meyubcan/stm32-4s-bms-home-automation/docs/img/schematic-1-power.png

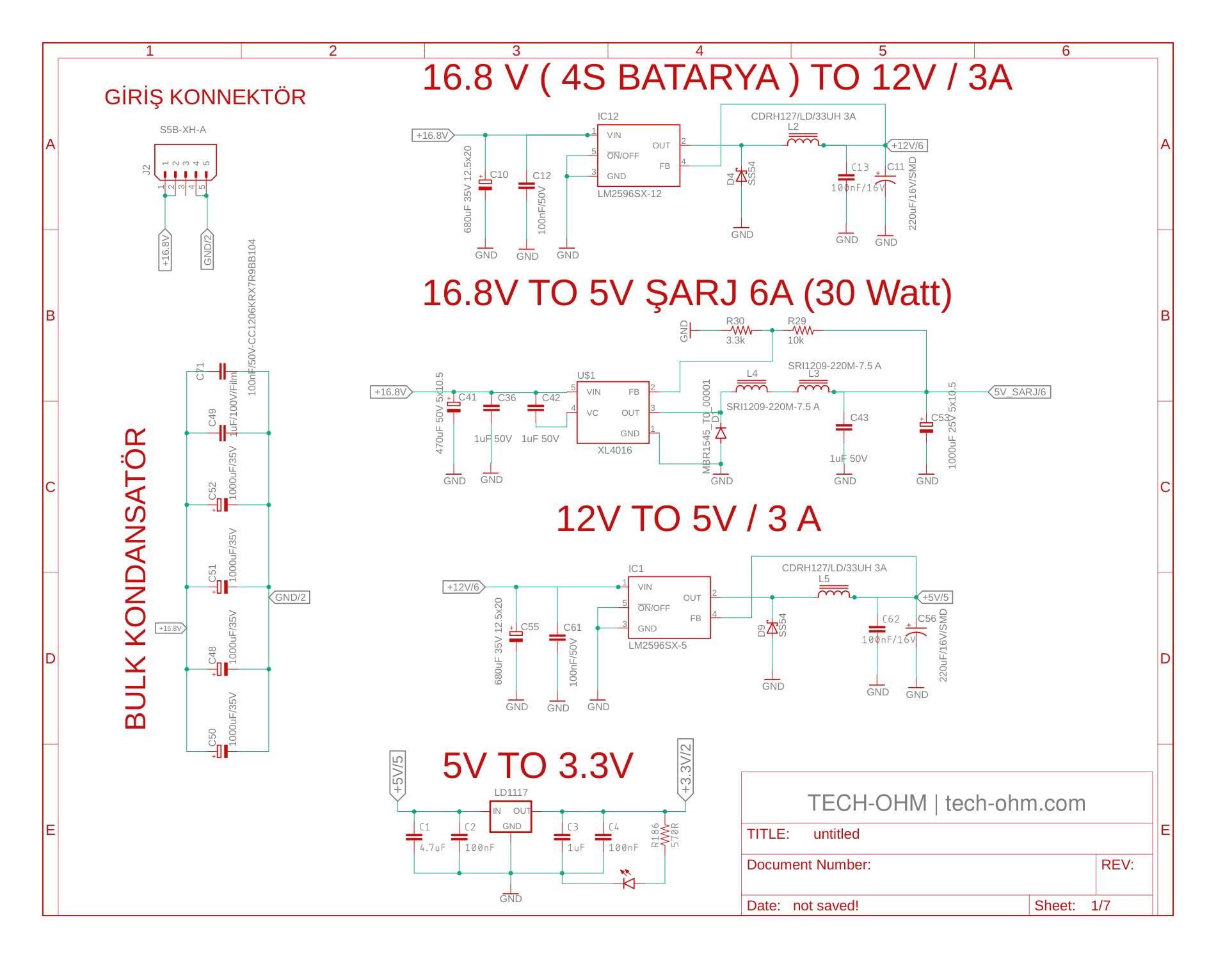
docs/img/schematic-1-power.png
