meyubcan/stm32-4s-bms-home-automation/docs/img/schematic-2-mcu.png

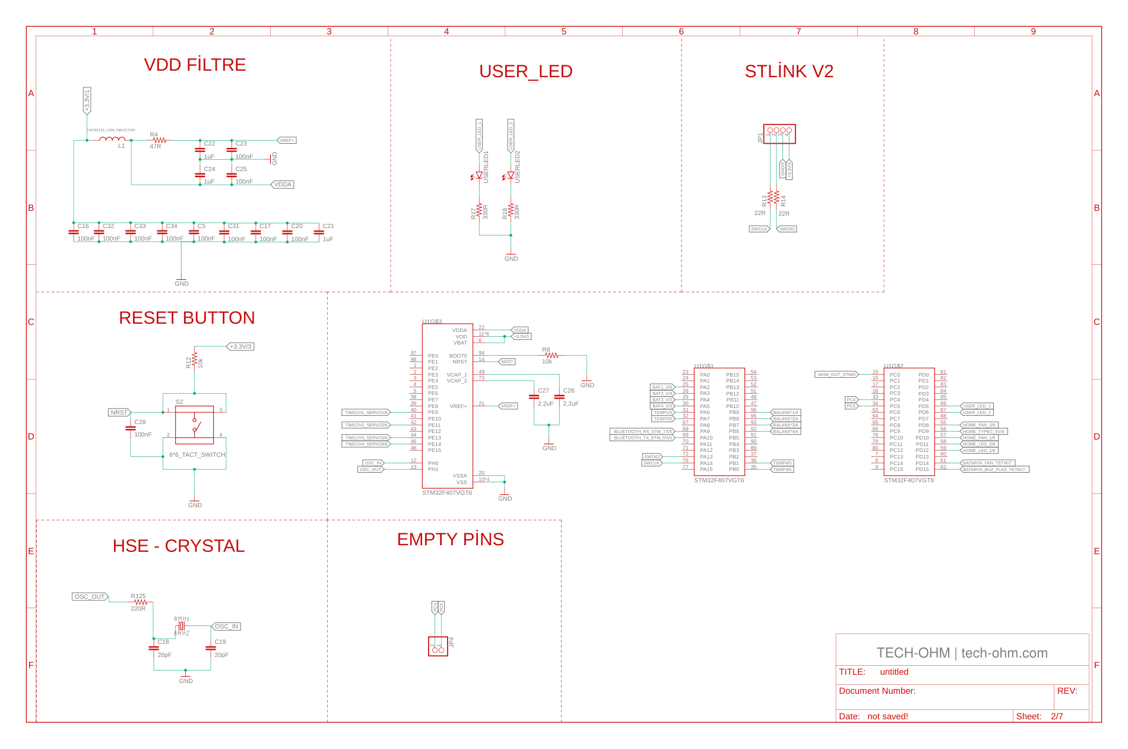
docs/img/schematic-2-mcu.png
