meyubcan/stm32-4s-bms-home-automation/docs/img/schematic-3-cell-voltage.png

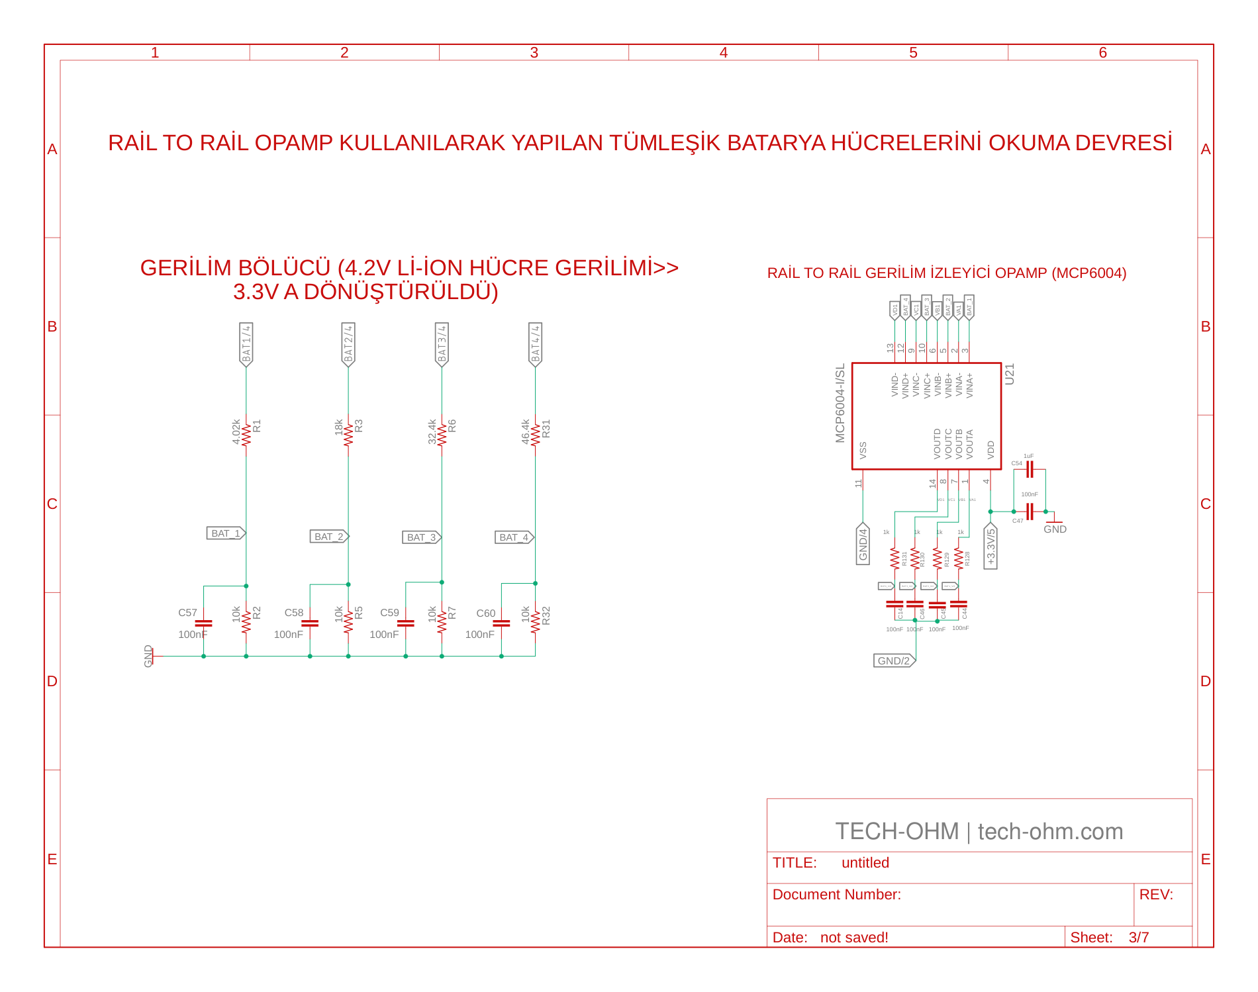
docs/img/schematic-3-cell-voltage.png
