meyubcan/stm32-4s-bms-home-automation/docs/img/schematic-4-balancing.png

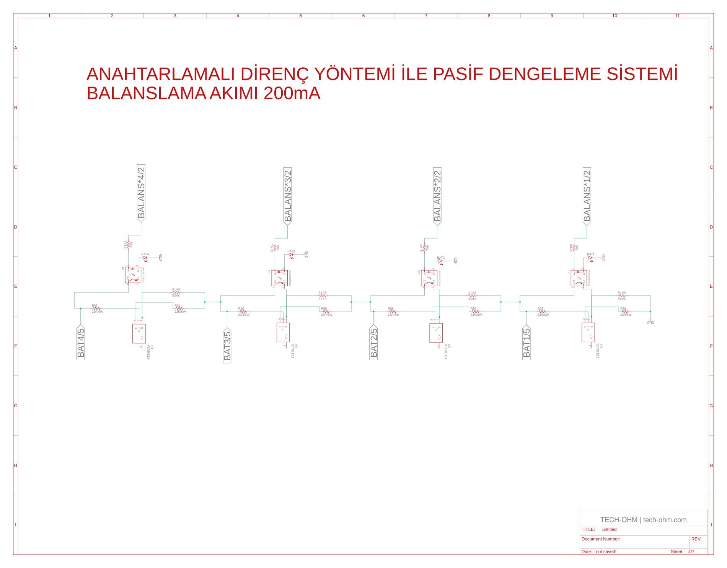
docs/img/schematic-4-balancing.png
