meyubcan/stm32-4s-bms-home-automation/docs/img/schematic-5-current-temp-bluetooth.png

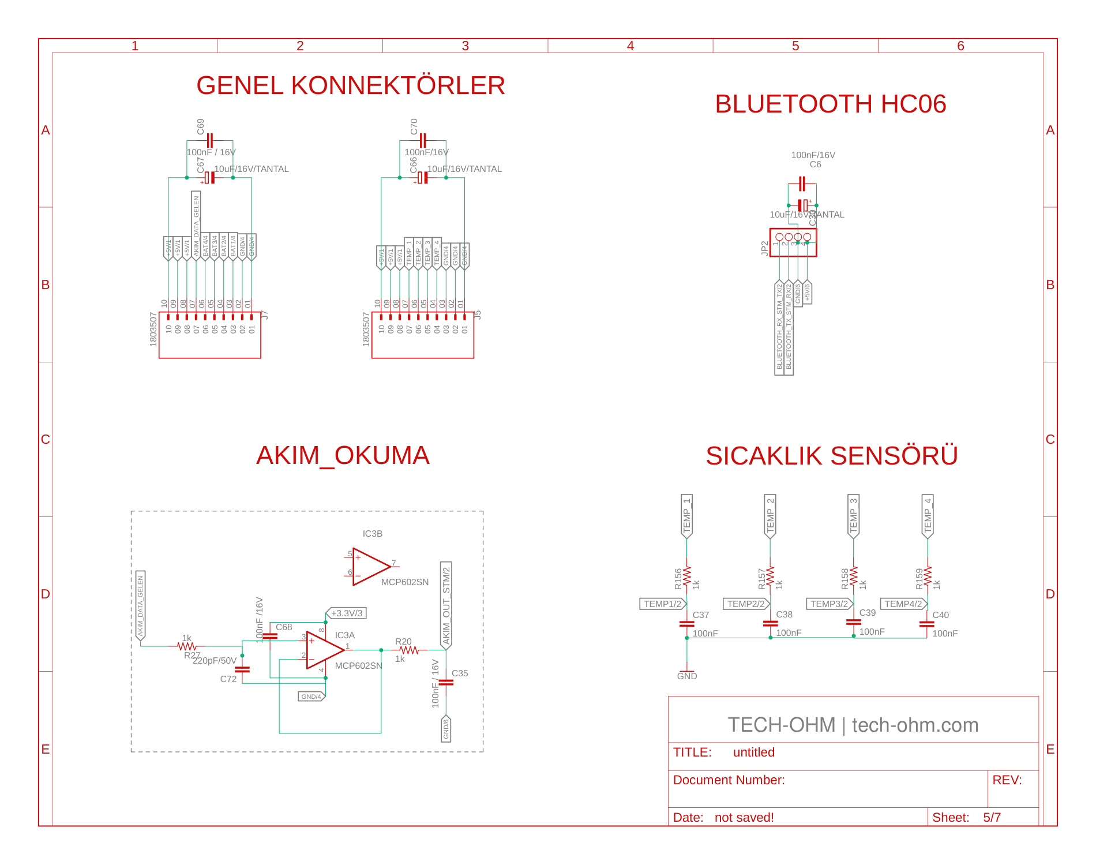
docs/img/schematic-5-current-temp-bluetooth.png
