meyubcan/stm32-4s-bms-home-automation/docs/img/schematic-6-home-control.png

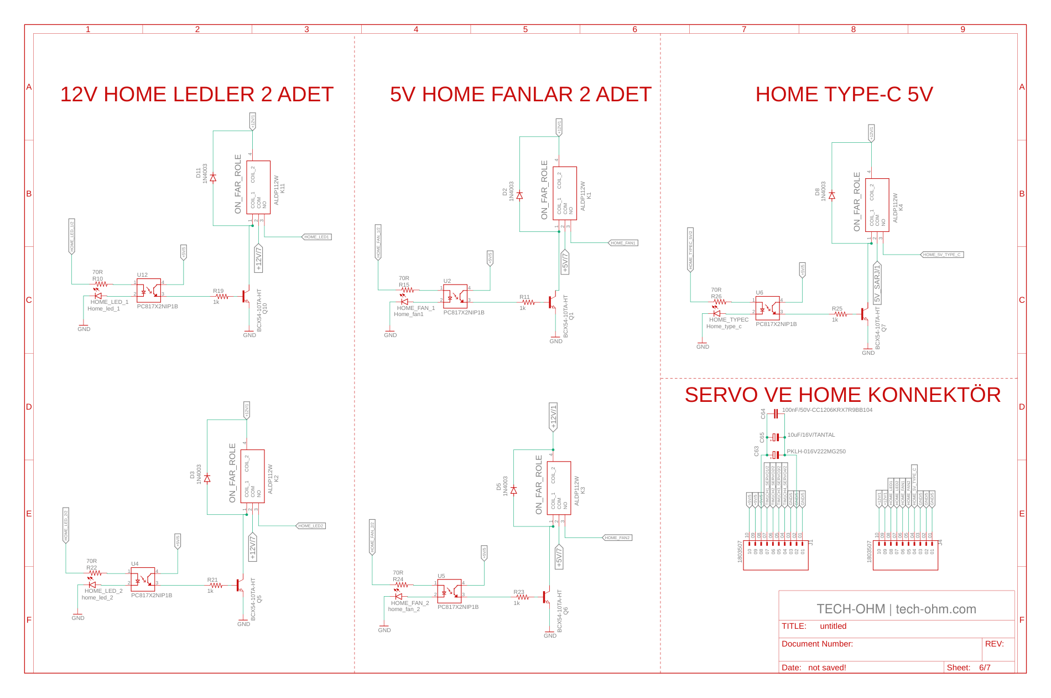
docs/img/schematic-6-home-control.png
