meyubcan/stm32-4s-bms-home-automation/docs/img/schematic-7-fan-buzzer.png

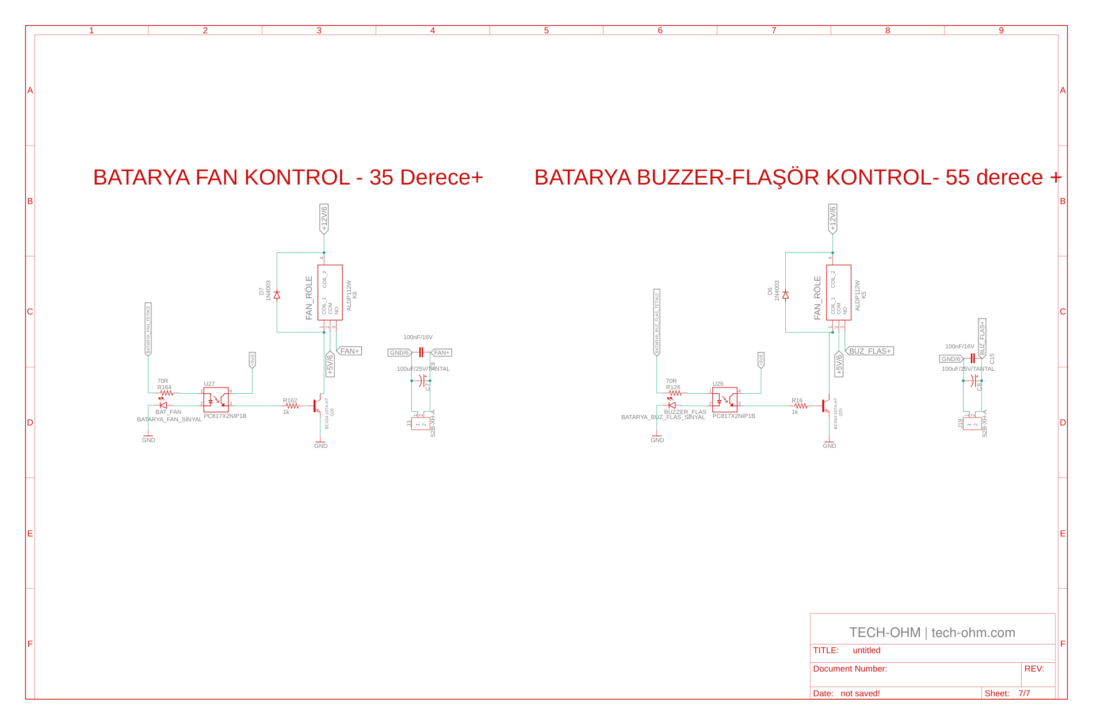
docs/img/schematic-7-fan-buzzer.png
