meyubcan/stm32-4s-bms-home-automation/docs/bom.csv

Qty | Value | Package | Designators
1 | STM32F407VGT6 | LQFP-100 | U1
1 | LM2596SX-12 | TO263-5 | IC12
1 | LM2596SX-5 | TO263-5 | IC1
1 | XL4016 | TO220-5 | U$1
1 | LD1117 3.3 V | SOT223 | LD1117
1 | MCP6004-I/SL | SOIC-14 | U21
1 | MCP602SN | SO08 | IC3
4 | PC817X2NIP0F | SMD-4 | U8, U9, U10, U11
7 | PC817X2NIP1B | SMD-4 | U2, U4, U5, U6, U12, U26, U27
7 | ALDP112W relay | ALDP112W | K1, K2, K3, K4, K5, K6, K11
7 | BCX54-10TA | SOT89 | Q1, Q5, Q6, Q7, Q10, Q25, Q26
4 | FZT851TA | SOT223 | Q2, Q3, Q4, Q9
1 | MBR1545 | TO220AC | D1
2 | SS54 | SMB | D4, D9
7 | 1N4003 | DO41 | D2, D3, D5, D6, D7, D8, D11
1 | 8 MHz crystal | HC49US | 8MHZ
2 | 33 uH 3 A (CDRH127) | CDRH127 | L2, L5
2 | 22 uH 7.5 A (SRI1209-220M) | SRI1209 | L3, L4
1 | 742792133 (VDDA filter) | 1206 | L1
8 | 23R 6 W | R2512 | R55, R56, R57, R58, R59, R60, R61, R62
4 | 560k | R0805 | R190, R193, R196, R199
4 | 70R | R0805 | R191, R194, R197, R200
7 | 70R | M0805 | R10, R15, R22, R24, R26, R126, R164
1 | 570R | R0805 | R186
12 | 1k | M0805 | R11, R16, R19, R20, R21, R23, R25, R156, R157, R158, R159, R162
5 | 1k | R0805 | R27, R128, R129, R130, R131
6 | 10k | R0805 | R2, R5, R7, R8, R12, R32
1 | 10k | R1206 | R29
1 | 3.3k | R1206 | R30
1 | 4.02k | R0805 | R1
1 | 18k | R0805 | R3
1 | 32.4k | R0805 | R6
1 | 46.4k | R0805 | R31
1 | 47R | R0805 | R4
1 | 220R | R0805 | R125
2 | 22R | M0805 | R13, R14
2 | 330R | M0805 | R17, R18
4 | 1000uF 35V | E5-13 | C48, C50, C51, C52
1 | 1000uF 25V | E5-10.5 | C53
2 | 680uF 35V | E5-13 | C10, C55
1 | 470uF 50V | E5-10.5 | C41
1 | 2200uF 16V (PKLH-016V222MG250) | E5-10.5 | C63
2 | 220uF 16V SMD | 6.3x5.8 | C11, C56
2 | 100uF 25V tantalum | 7343 | C7, C8
4 | 10uF 16V tantalum | 3528 | C30, C65, C66, C67
1 | 4.7uF | 0805 | C1
1 | 1uF 100V film | 5 mm pitch | C49
3 | 1uF 50V | C0805 | C36, C42, C43
5 | 1uF | C0805 | C3, C21, C22, C24, C54
2 | 2.2uF | C0805 | C26, C27
26 | 100nF | C0805 | C2, C4, C5, C14, C16, C17, C20, C23, C25, C28, C31, C32, C33, C34, C37, C38, C39, C40, C44, C45, C46, C47, C57, C58, C59, C60
9 | 100nF 16V | C0805 | C6, C9, C13, C15, C35, C62, C68, C69, C70
4 | 100nF 50V | C1206 | C12, C61, C64, C71
1 | 220pF 50V | C0805 | C72
2 | 20pF | C0805 | C18, C19
5 | LED | 0805 | BAT1, BAT2, BAT3, BAT4, POWER_LED
9 | LED | 1206 | USERLED1, USERLED2, BUZZER_FLAS, BAT_FAN, HOME_FAN_1, HOME_FAN_2, HOME_LED_1, HOME_LED_2, HOME_TYPEC
1 | Tact switch 6x6 | SMT | S2
4 | Phoenix 1803507 terminal block | 10 pos | J1, J4, J5, J7
2 | JST S2B-XH-A | 2 pos | J3, J19
1 | JST S5B-XH-A | 5 pos | J2
2 | Pin header 1x4 | 2.54 mm | JP1, JP2
1 | Pin header 1x2 | 2.54 mm | JP4
