meyubcan/stm32-4s-bms-home-automation/docs/schematic.pdf

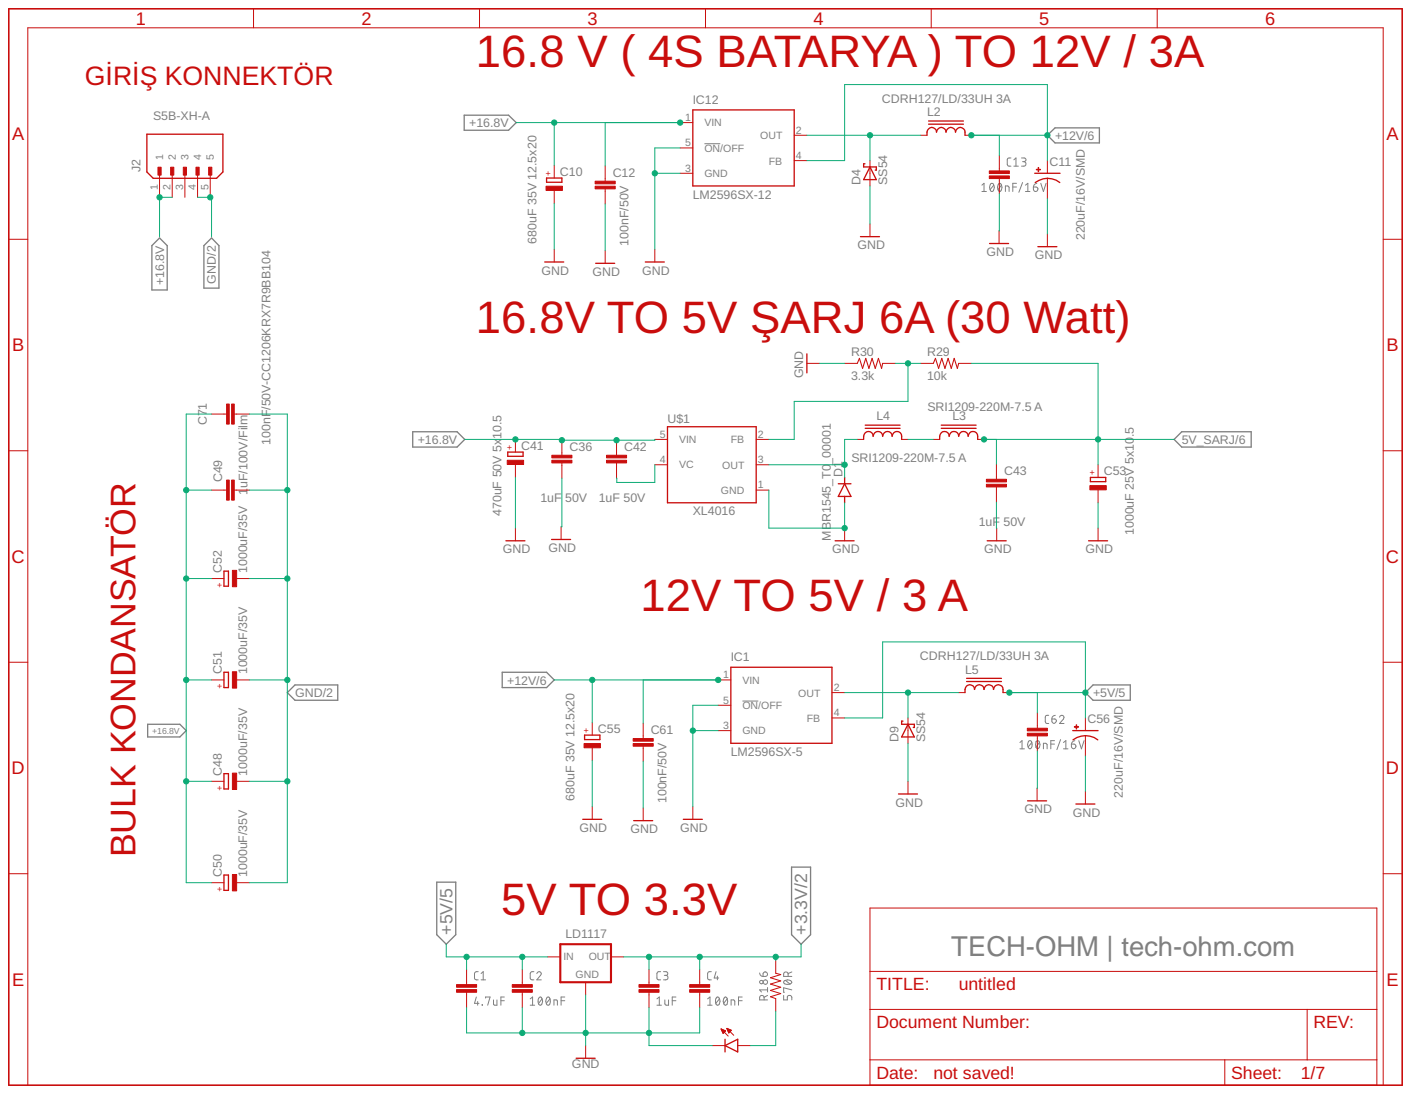
[picture p12: page 1]

TECH-OHM | tech-ohm.com

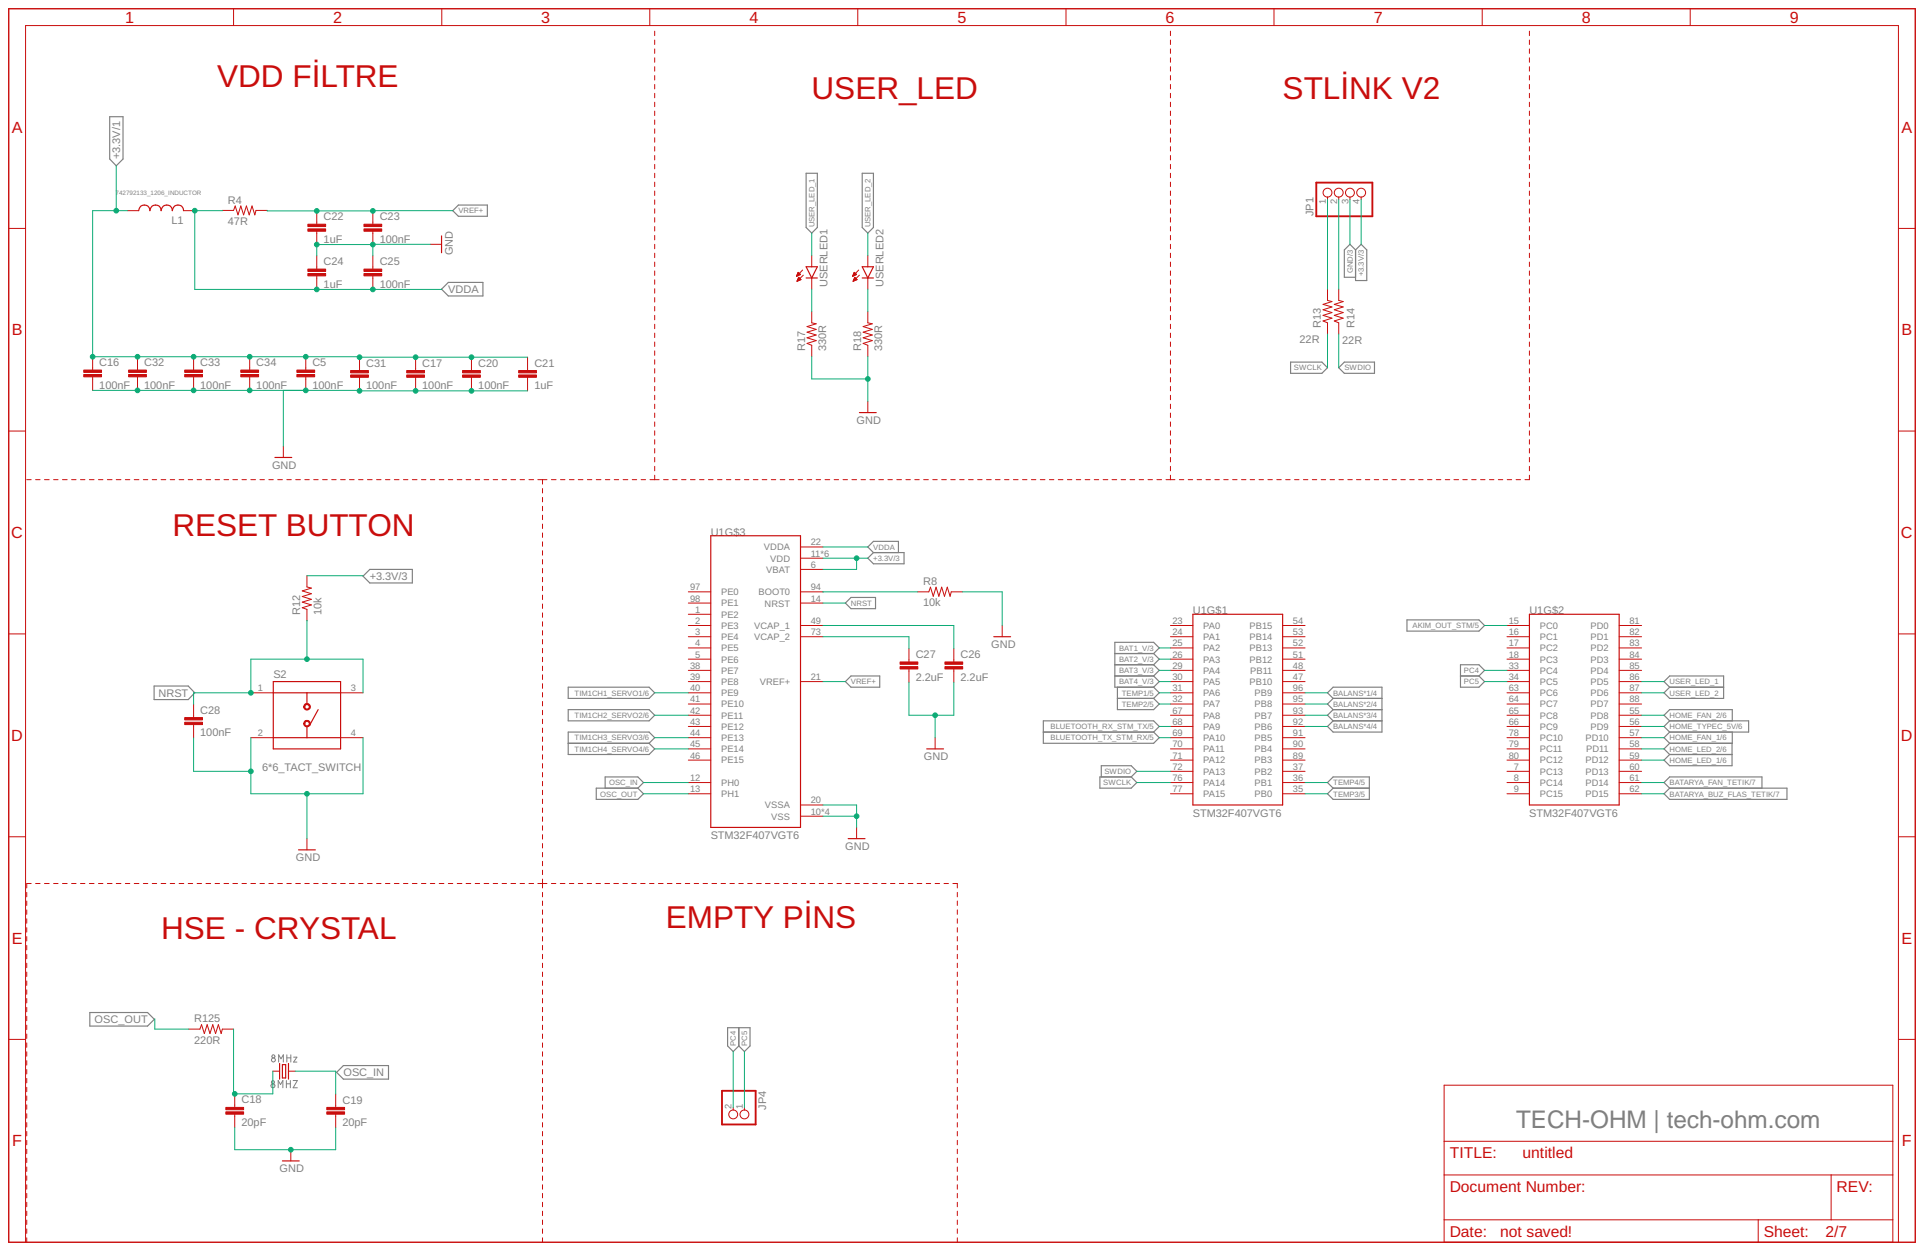
[picture p13: page 2]

VDD FİLTRE

TECH-OHM | tech-ohm.com

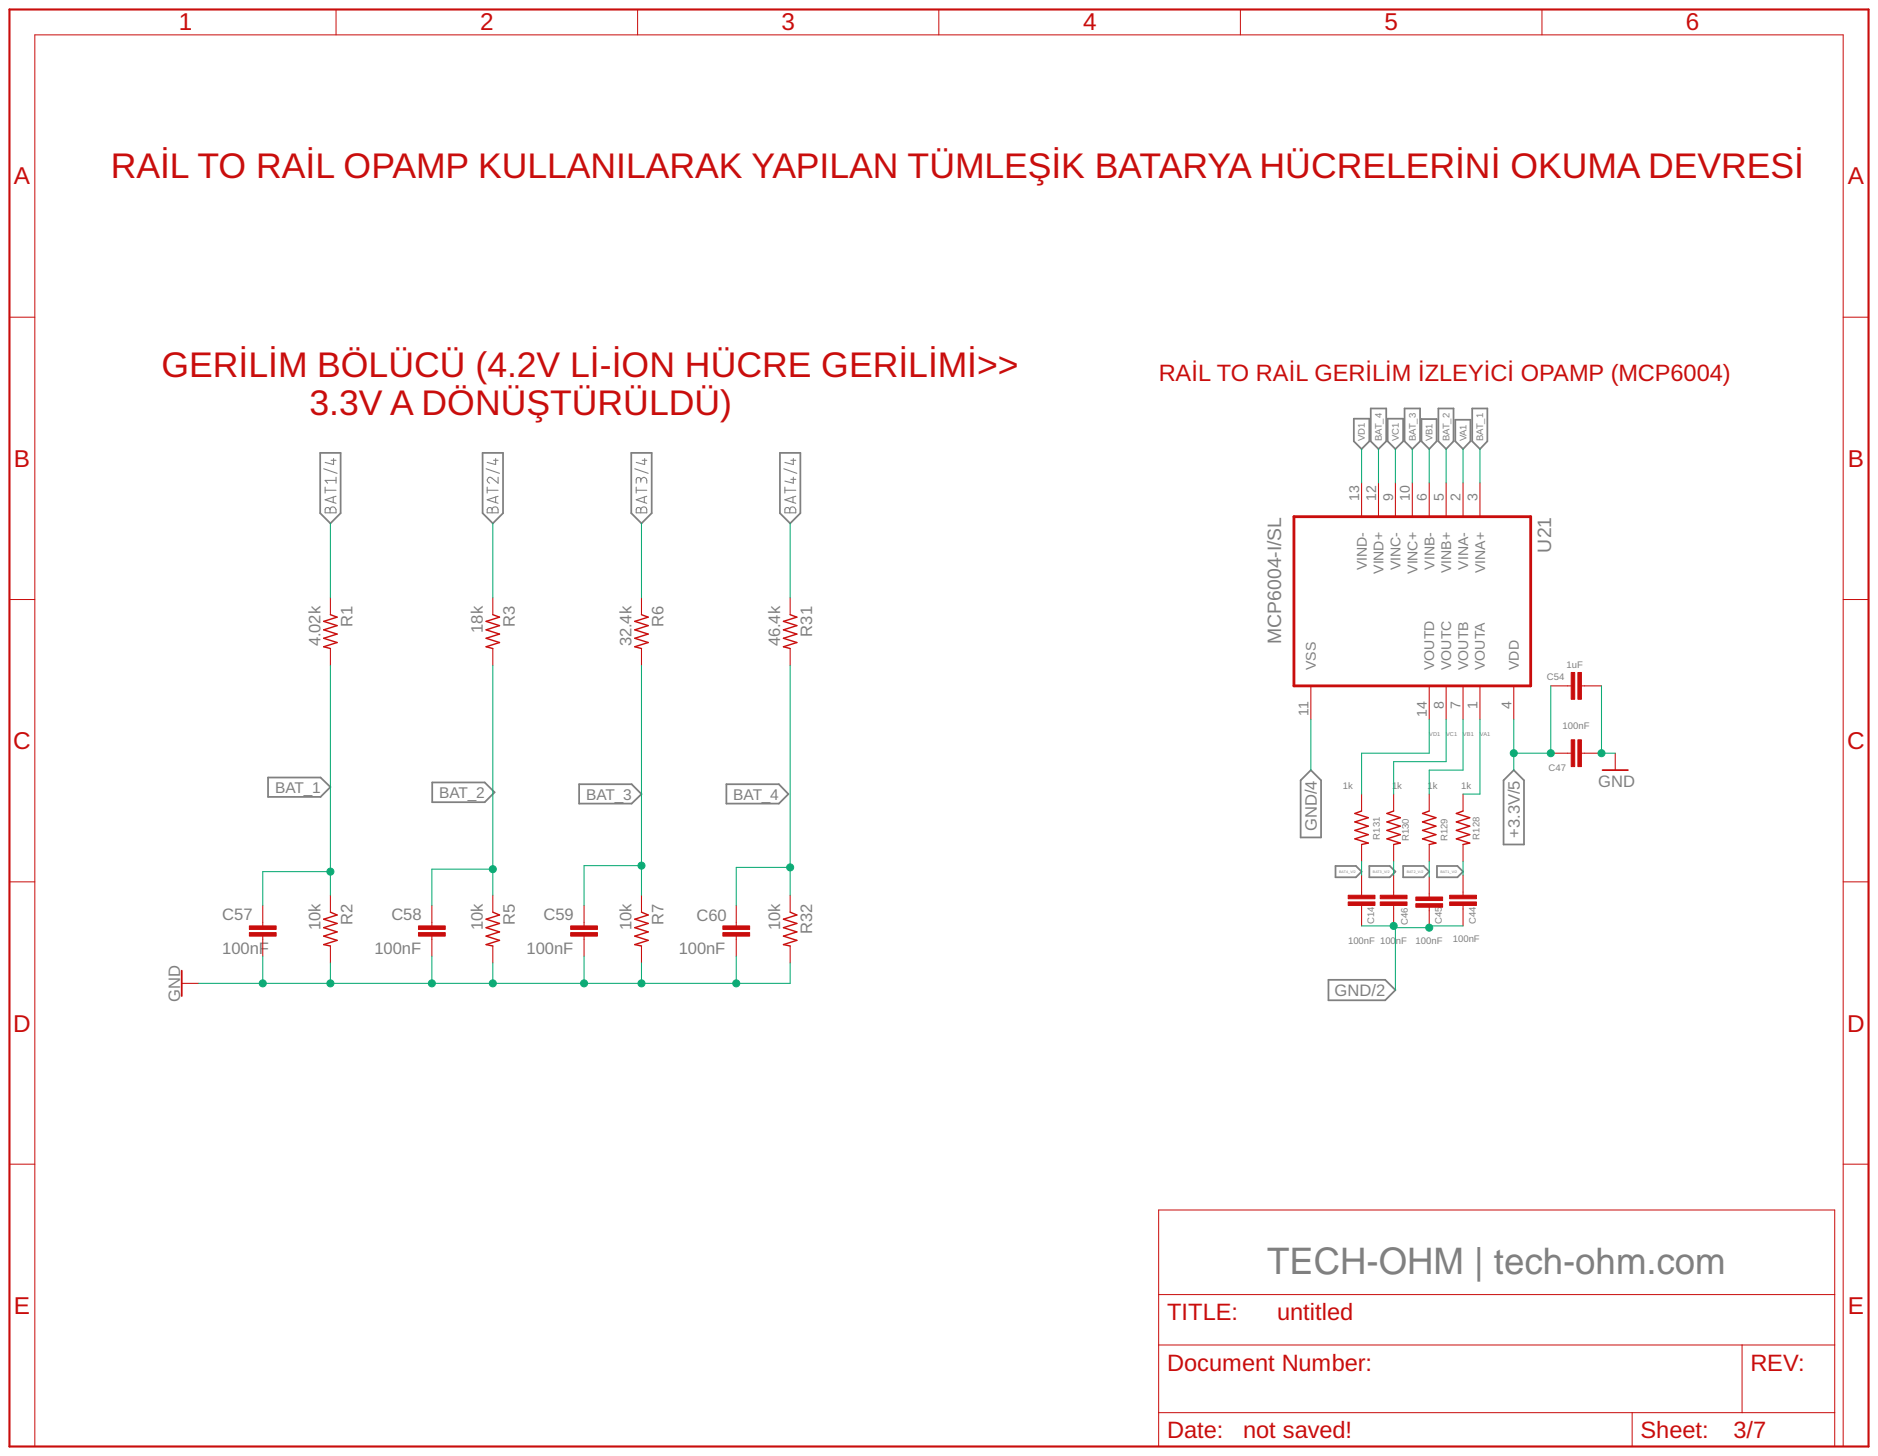
[picture p14: page 3]

RAİL TO RAİL OPAMP KULLANILARAK YAPILAN TÜMLEŞİK BATARYA HÜCRELERİNİ OKUMA DEVRESİ GERİLİM BÖLÜCÜ (4.2V Lİ-İON HÜCRE GERİLİMİ>>

TECH-OHM | tech-ohm.com

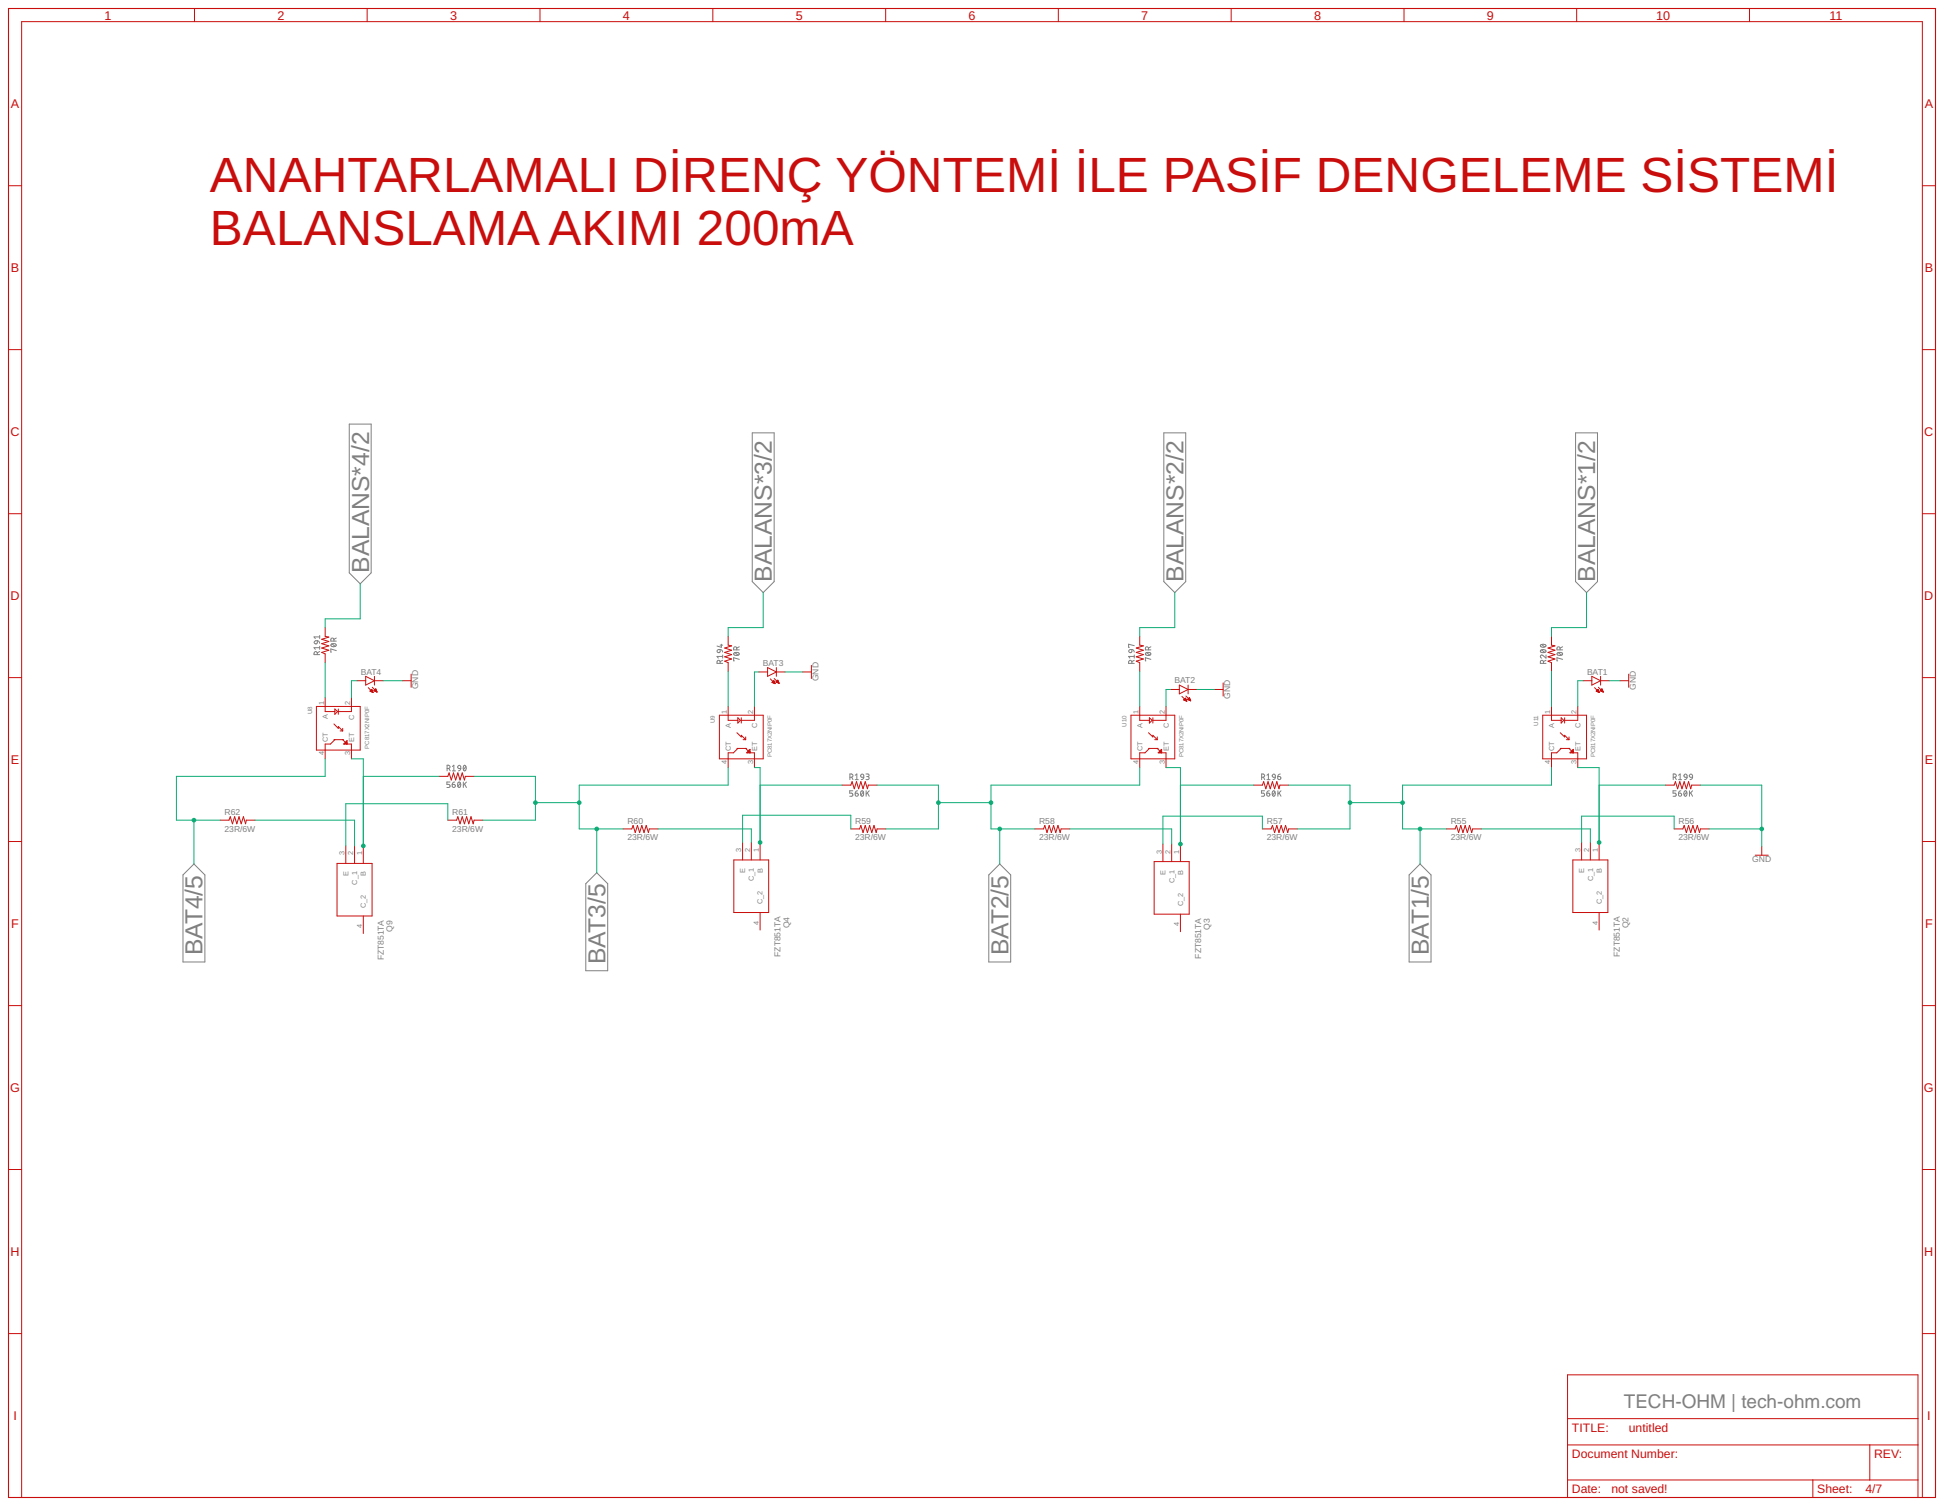
[picture p15: page 4]

PC817X2NIP0F PC817X2NIP0F PC817X2NIP0F PC817X2NIP0F GND GNDGND 23R/6W 23R/6W 23R/6W 23R/6W 23R/6W 23R/6W 23R/6W 23R/6W GND FZT851TA FZT851TA FZT851TA FZT851TA GND A 1 C 2 CT 4 ET 3 U8 BAT4 A 1 C 2 CT 4 ET 3 U9 A 1 C 2 CT 4 ET 3 U10 BAT2 A 1 C 2 CT 4 ET 3 U11 BAT1 R60 R59 R58 R57 R55 R56 R62 R61 B 1 C_1 2 E 3 C_2 4Q2 B 1 C_1 2 E 3 C_2 4Q3 B 1 C_1 2 E 3 C_2 4Q4 B 1 C_1 2 E 3 C_2 4Q9 BAT3 BAT4/5 BALANS*4/2 BAT3/5 BALANS*3/2 BAT2/5 BALANS*2/2 BAT1/5 BALANS*1/2 ANAHTARLAMALI DİRENÇ YÖNTEMİ İLE PASİF DENGELEME SİSTEMİ BALANSLAMA AKIMI 200mA ABCDEFGHI ABCDEFGHI 1 2 3 4 5 6 7 8 9 10 11 Date: Sheet: REV: TITLE: Document Number: not saved! 4/7 untitled

TECH-OHM | tech-ohm.com

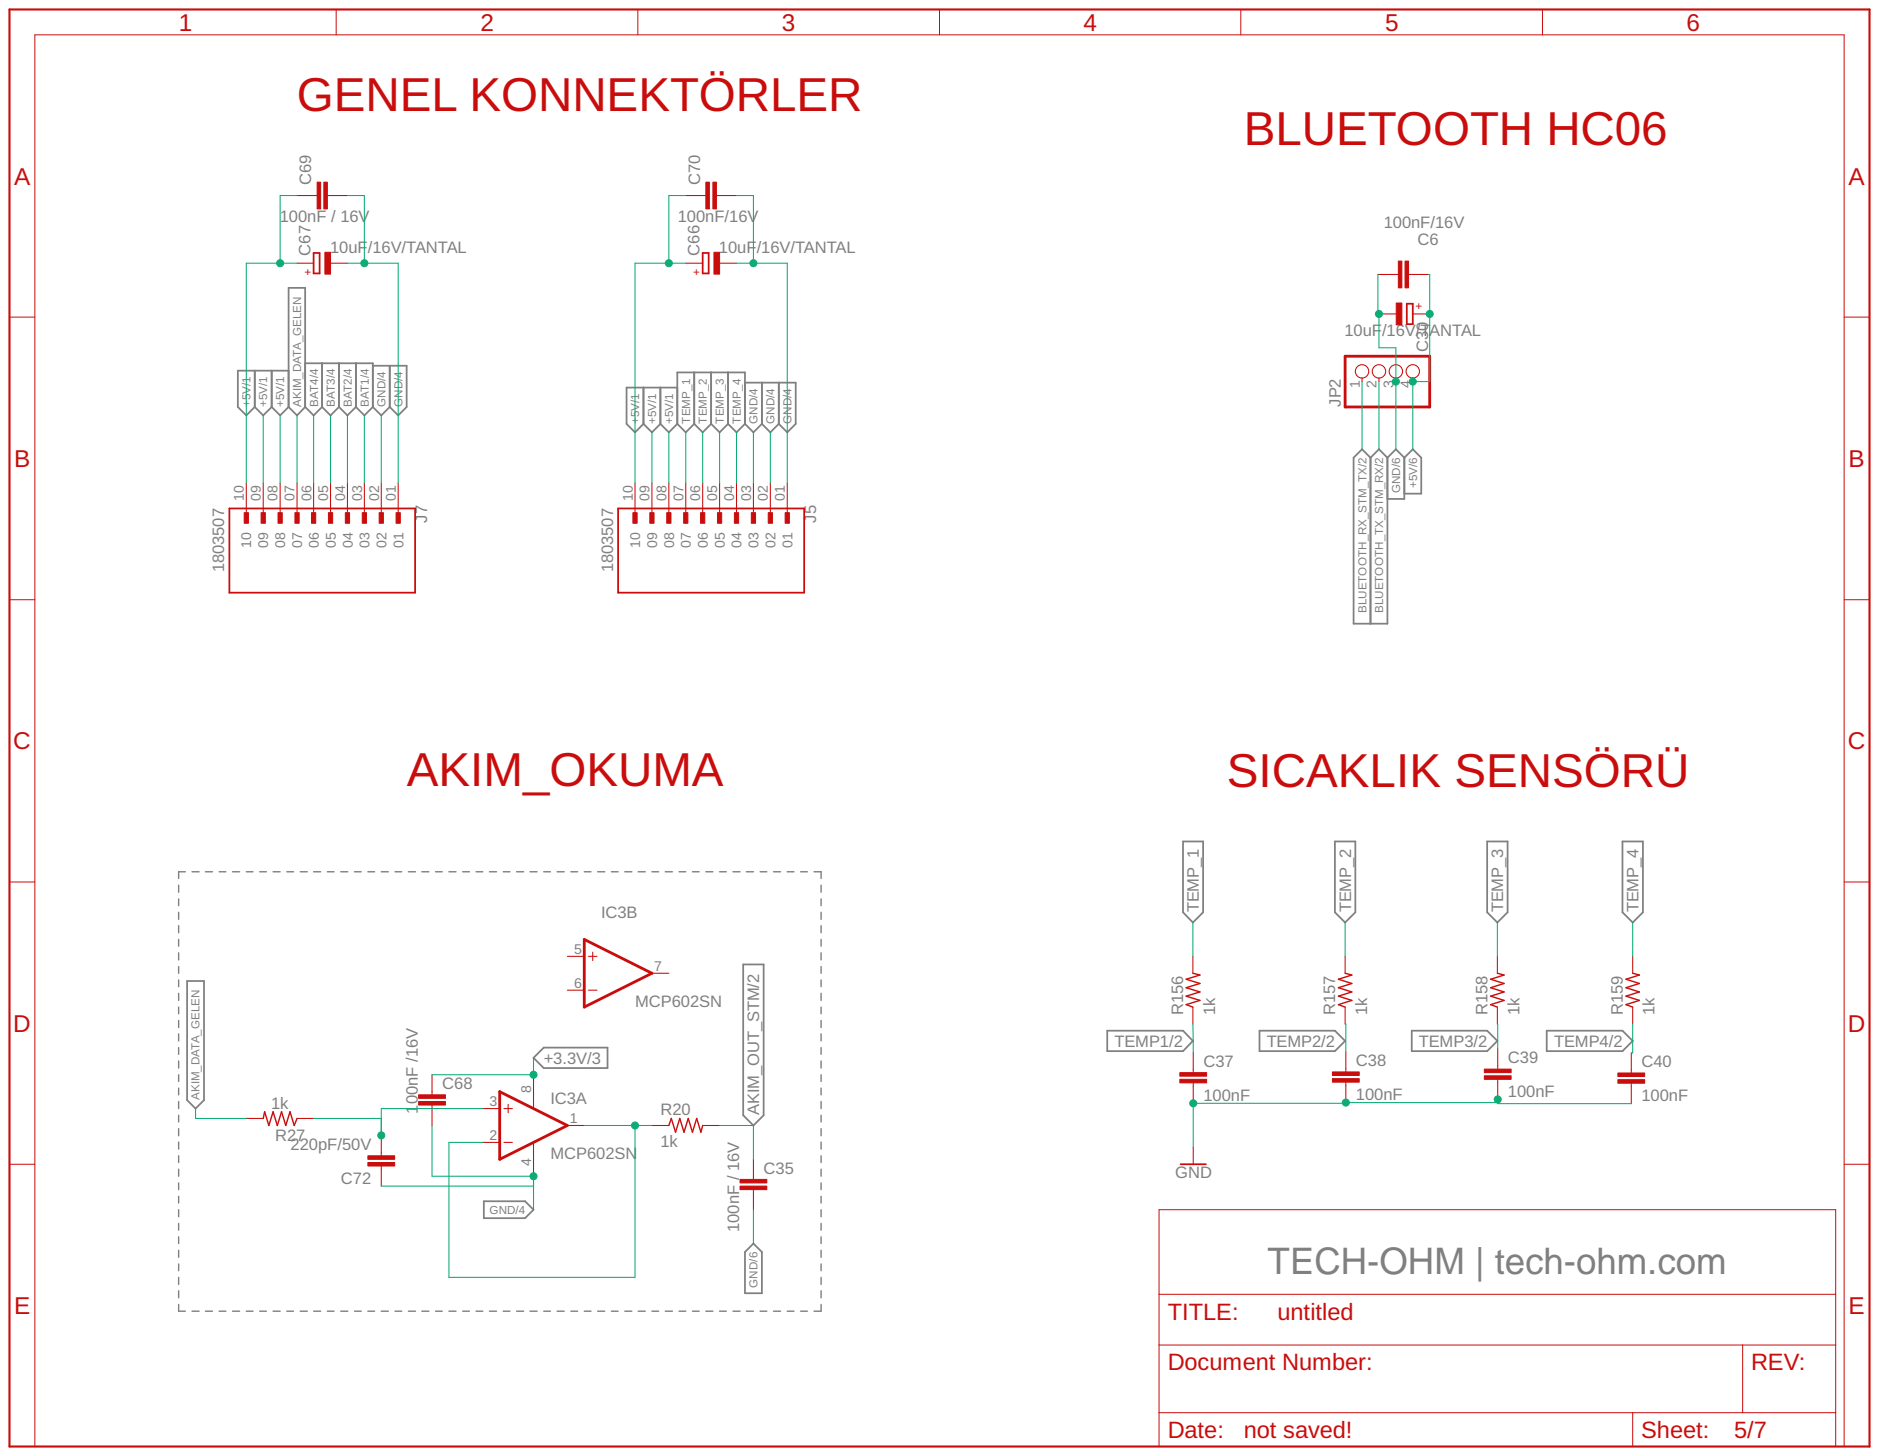
[picture p16: page 5]

GND/4 GND/4 GND/4 GND/6 GND/4 GND/4 GND/4

TECH-OHM | tech-ohm.com

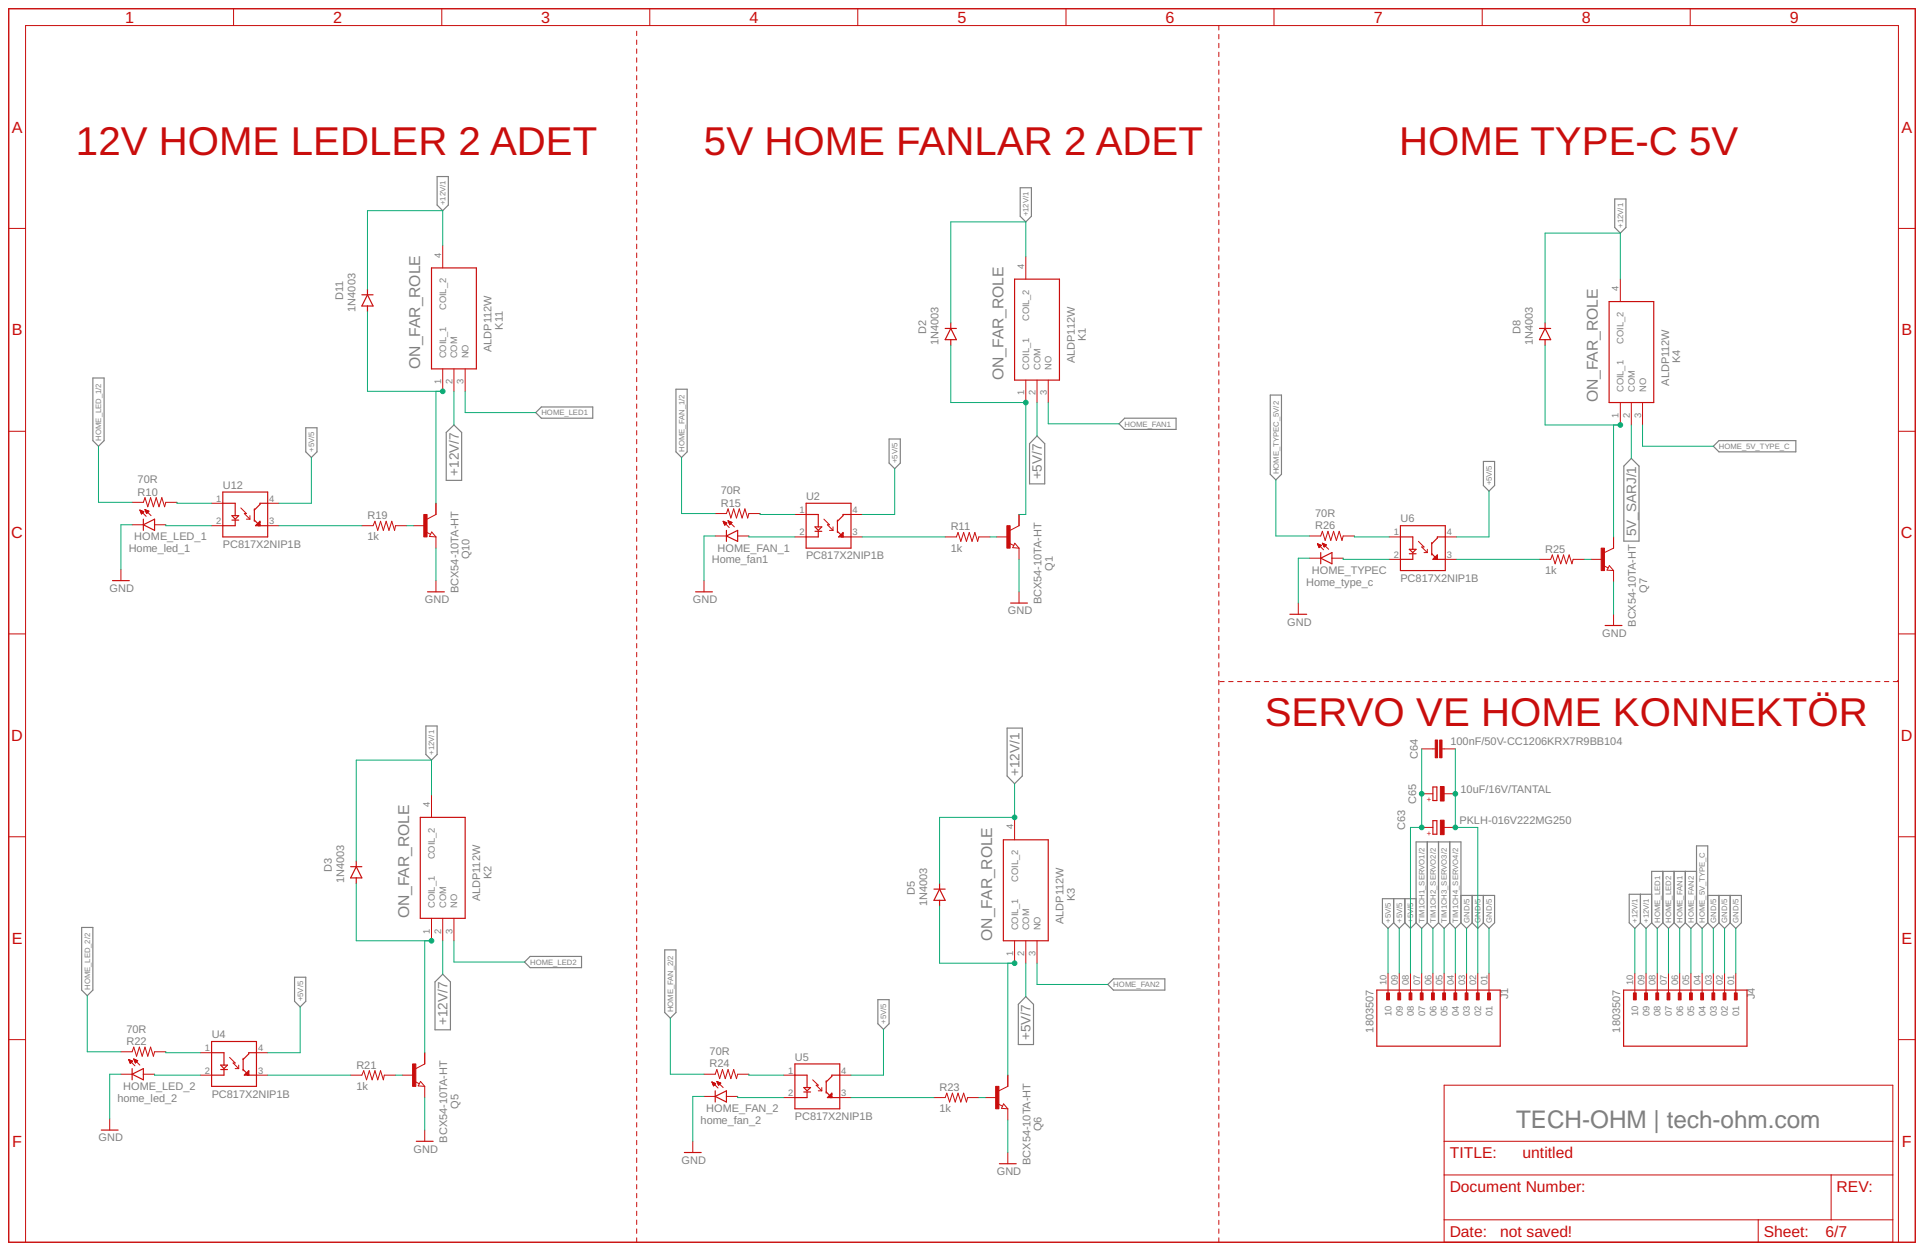
[picture p17: page 6]

ALDP112W BCX54-10TA-HT 1k PC817X2NIP1B 70R Home_led_1 GND GND 1N4003 ALDP112W BCX54-10TA-HT 1k PC817X2NIP1B 70R Home_fan1 GND GND 1N4003 ALDP112W BCX54-10TA-HT 1k PC817X2NIP1B 70R home_led_2 GND GND 1N4003 ALDP112W BCX54-10TA-HT 1k PC817X2NIP1B 70R home_fan_2 GND GND 1N4003 ALDP112W BCX54-10TA-HT 1k PC817X2NIP1B 70R Home_type_c GND GND 1N4003 1803507 1803507 PKLH-016V222MG250 100nF/50V-CC1206KRX7R9BB104 10uF/16V/TANTAL ON_FAR_ROLE ON_FAR_ROLE ON_FAR_ROLE ON_FAR_ROLE ON_FAR_ROLE COIL_1 1 COM 2 NO 3 COIL_2 4 K11 Q10 R19 12 43 U12 R10 HOME_LED_1 D11 COIL_1 1 COM 2 NO 3 COIL_2 4 K1 Q1 R11 12 43 U2 R15 HOME_FAN_1 D2 COIL_1 1 COM 2 NO 3 COIL_2 4 K2 Q5 R21 12 43 U4 R22 HOME_LED_2 D3 COIL_1 1 COM 2 NO 3 COIL_2 4 K3 Q6 R23 12 43 U5 R24 HOME_FAN_2 D5 COIL_1 1 COM 2 NO 3 COIL_2 4 K4 Q7 R25 12 43 U6 R26 HOME_TYPEC D8 01 01 02 02 03 03 04 04 05 05 06 06 07 07 08 08 09 09 10 10 J1 01 01 02 02 03 03 04 04 05 05 06 06 07 07 08 08 09 09 10 10 J4 C63 C64 C65 GND/5 GND/5 GND/5 GND/5 GND/5 GND/5 +5V/5 +5V/5 +5V/5 +5V/5 +5V/5 +5V/7 +5V/7 +5V/5 +5V/5 +5V/5 5V_SARJ H/1OME_TYPEC_5V/2 HOME_LED1 HOME_LED1 HOME_LED2 HOME_LED2 HOME_LED_1/2 HOME_LED_2/2 HOME_FAN1 HOME_FAN1 HOME_FAN2 HOME_FAN2 HOME_FAN_1/2 HOME_FAN_2/2 HOME_5V_TYPE_C HOME_5V_TYPE_C +12V/1 +12V/7 +12V/7 +12V/1 +12V/1 +12V/1 +12V/1 +12V/1 +12V/1 TIM1CH1_SERVO1/2 TIM1CH2_SERVO2/2 TIM1CH3_SERVO3/2 TIM1CH4_SERVO4/2 12V HOME LEDLER 2 ADET 5V HOME FANLAR 2 ADET HOME TYPE-C 5V SERVO VE HOME KONNEKTÖR ABCDEF ABCDEF 1 2 3 4 5 6 7 8 9 Date: Sheet: REV: TITLE: Document Number: not saved! 6/7 untitled ++

TECH-OHM | tech-ohm.com

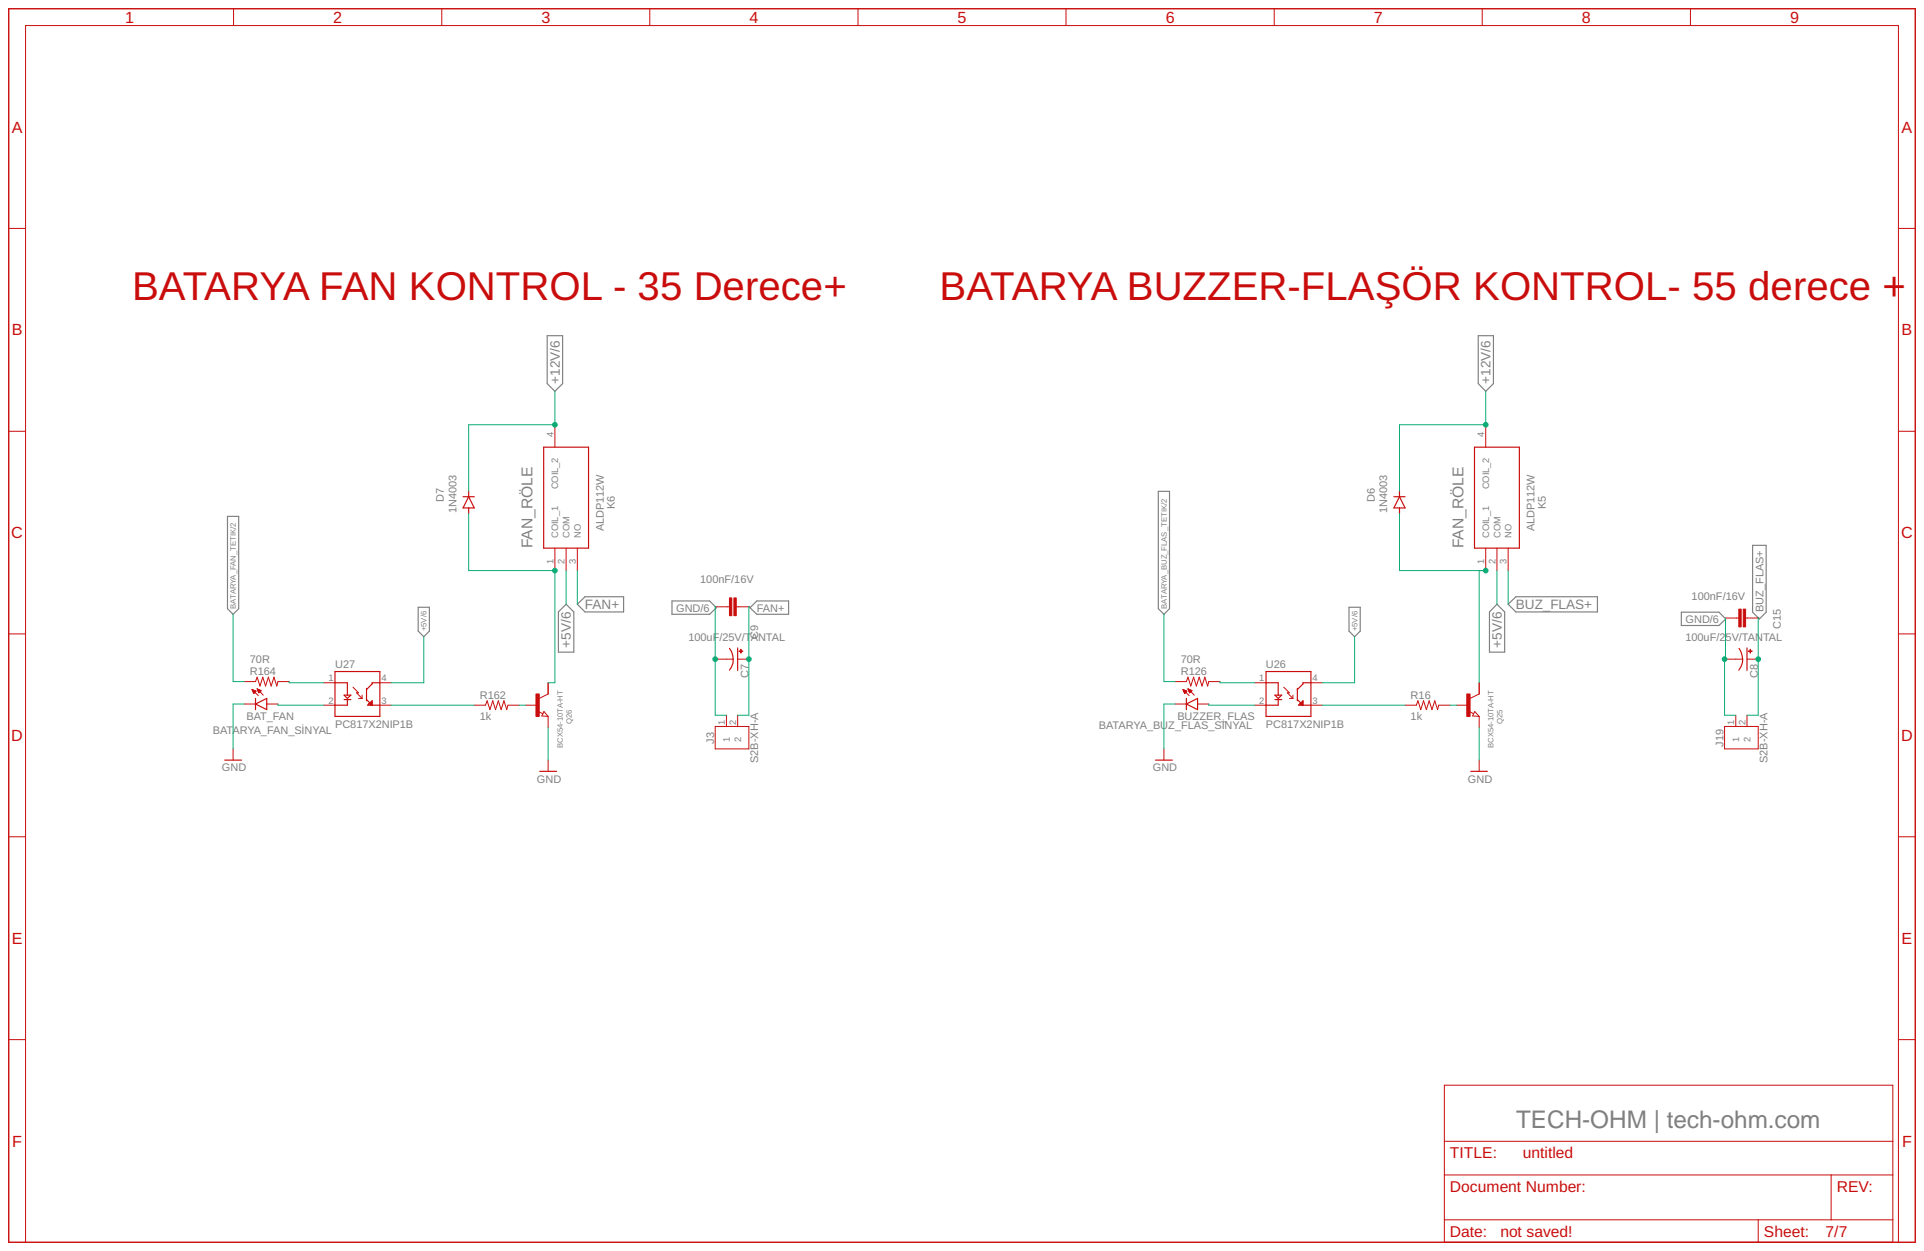
[picture p18: page 7]

ALDP112W BCX54-10TA-HT 1k PC817X2NIP1B 70R BATARYA_BUZ_FLAS_SİNYAL GND GND 1N4003 ALDP112W BCX54-10TA-HT 1k PC817X2NIP1B 70R BATARYA_FAN_SİNYAL GND GND 1N4003 S2B-XH-A S2B-XH-A 100uF/25V/TANTAL 100uF/25V/TANTAL 100nF/16V 100nF/16V FAN_RÖLE FAN_RÖLE COIL_1 1 COM 2 NO 3 COIL_2 4 K5 Q25 R16 12 43 U26 R126 BUZZER_FLAS D6 COIL_1 1 COM 2 NO 3 COIL_2 4 K6 Q26 R162 12 43 U27 R164 BAT_FAN D7 1 1 2 2 J191 1 2 2 J3 C7 C8 C9C15BATARYA_FAN_TETIK/2 GND/6 GND/6 BATARYA_BUZ_FLAS_TETIK/2 +5V/6 +5V/6 +5V/6 +5V/6 FAN+ FAN+ BUZ_FLAS+ BUZ_FLAS+ +12V/6 +12V/6 BATARYA FAN KONTROL - 35 Derece+ BATARYA BUZZER-FLAŞÖR KONTROL- 55 derece + ABCDEF ABCDEF 1 2 3 4 5 6 7 8 9 Date: Sheet: REV: TITLE: Document Number: not saved! 7/7 untitled

TECH-OHM | tech-ohm.com
