meyubcan/stm32-4s-bms-home-automation/Core/Src/main.c

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
/* Includes ------------------------------------------------------------------*/
#include "main.h"

/* USER CODE BEGIN Includes */

#include "adc_read.h"
#include "protection.h"
#include "balance.h"
#include "bluetooth.h"
/* USER CODE END Includes */

/* USER CODE BEGIN PTD */
typedef struct { GPIO_TypeDef *port; uint16_t pin; const char *name; } RelayCh;
typedef struct { uint32_t channel; const char *name; } ServoCh;
/* USER CODE END PTD */

/* USER CODE BEGIN PD */
#define SERVO_0_DEG       1000
#define SERVO_90_DEG      1500
#define SERVO_180_DEG     2000
#define RELAY_ACTIVE_LOW  0
/* USER CODE END PD */

ADC_HandleTypeDef hadc1;
DMA_HandleTypeDef hdma_adc1;

TIM_HandleTypeDef htim1;

UART_HandleTypeDef huart1;

void SystemClock_Config(void);
static void MX_GPIO_Init(void);
static void MX_DMA_Init(void);
static void MX_ADC1_Init(void);
static void MX_USART1_UART_Init(void);
static void MX_TIM1_Init(void);
/* USER CODE BEGIN PFP */
/* Outputs controlled from the app. The battery fan (PD14), buzzer (PD15) and
 * user LEDs (PD5/PD6) are not here. Thermal_Update handles those. */
RelayCh relays[] = {
    { GPIOD, GPIO_PIN_8,  "HOME_FAN_2"    },
    { GPIOD, GPIO_PIN_9,  "HOME_TYPEC_5V" },  /* USB socket */
    { GPIOD, GPIO_PIN_10, "HOME_FAN_1"    },
    { GPIOD, GPIO_PIN_11, "HOME_LED_2"    },
    { GPIOD, GPIO_PIN_12, "HOME_LED_1"    },
    { GPIOB, GPIO_PIN_0,  "CHARGE"          },
    { GPIOB, GPIO_PIN_9,  "BALANCE_1"      },
    { GPIOB, GPIO_PIN_8,  "BALANCE_2"      },
    { GPIOB, GPIO_PIN_7,  "BALANCE_3"      },
    { GPIOB, GPIO_PIN_6,  "BALANCE_4"      },
};
#define RELAY_COUNT (sizeof(relays) / sizeof(relays[0]))

ServoCh servos[] = {
    { TIM_CHANNEL_1, "SERVO_1_PE9"  },
    { TIM_CHANNEL_2, "SERVO_2_PE11" },
    { TIM_CHANNEL_3, "SERVO_3_PE13" },
    { TIM_CHANNEL_4, "SERVO_4_PE14" },
};
#define SERVO_COUNT (sizeof(servos) / sizeof(servos[0]))
/* USER CODE END PV */

void SystemClock_Config(void);
static void MX_GPIO_Init(void);
static void MX_DMA_Init(void);
static void MX_ADC1_Init(void);
static void MX_TIM1_Init(void);

/* USER CODE BEGIN 0 */

/* USER CODE END PFP */

/* USER CODE BEGIN 0 */
static void relay_write(const RelayCh *r, uint8_t on)
{
#if RELAY_ACTIVE_LOW
    HAL_GPIO_WritePin(r->port, r->pin, on ? GPIO_PIN_RESET : GPIO_PIN_SET);
#else
    HAL_GPIO_WritePin(r->port, r->pin, on ? GPIO_PIN_SET : GPIO_PIN_RESET);
#endif
}
static void relay_all_off(void)
{
    for (uint32_t i = 0; i < RELAY_COUNT; i++) relay_write(&relays[i], 0);
}
static void servo_set_us(uint32_t channel, uint16_t pulse_us)
{
    __HAL_TIM_SET_COMPARE(&htim1, channel, pulse_us);
}
static void servo_start_all(void)
{
    for (uint32_t i = 0; i < SERVO_COUNT; i++) {
        HAL_TIM_PWM_Start(&htim1, servos[i].channel);
        servo_set_us(servos[i].channel, SERVO_0_DEG);
    }
}
/* USER CODE END PFP */

/* USER CODE BEGIN 0 */

/* USER CODE END PFP */

/**
  * @brief  The application entry point.
  * @retval int
  */
int main(void)
{
  /* MCU Configuration--------------------------------------------------------*/

  /* Reset of all peripherals, Initializes the Flash interface and the Systick. */
  HAL_Init();

  /* Configure the system clock */
  SystemClock_Config();

  /* Initialize all configured peripherals */
  MX_GPIO_Init();
  MX_DMA_Init();
  MX_ADC1_Init();
  MX_USART1_UART_Init();
  MX_TIM1_Init();
  /* USER CODE BEGIN 2 */
  relay_all_off();
  servo_start_all();
  ADC_Filter_Start(&hadc1);
  HAL_Delay(100);
  ADC_CalibrateACSZero();        /* calibrate at zero current (no load) */

  BT_Init(&huart1);
  /* USER CODE END 2 */

  /* Infinite loop */
  /* USER CODE BEGIN WHILE */
  while (1)
  {
    /* USER CODE END WHILE */

    /* USER CODE BEGIN 3 */
	  Energy_Update();
	  Thermal_Update();
	  Balance_Update();

	     /* Bluetooth: send telemetry every 500 ms */
	     static uint32_t last_tx = 0;
	     if (HAL_GetTick() - last_tx >= 500) {
	         last_tx = HAL_GetTick();
	         BT_SendTelemetry();
	     }

	     HAL_Delay(10);

  }
  /* USER CODE END 3 */
}

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
