meyubcan/stm32-4s-bms-home-automation/(commit log)

2026-10-12 4S Li-ion batarya izleme, pasif dengeleme, sıcaklık koruması ve Bluetooth kontrollü ev otomasyonu: STM32F407
2026-10-13 Guc kati semasi, malzeme listesi ve Android uygulamasi eklendi
    [bom.csv]
